eusales/WaterQuality/docs/hardware/pinout.md

| GPIO | Pino físico | Função | Barramento |
|---|---|---|---|
| GPIO 18 | 30 | SCK | SPI (TFT + SD) |
| GPIO 23 | 37 | MOSI | SPI (TFT + SD) |
| GPIO 19 | 31 | MISO | SPI (SD) |
| GPIO 5 | 29 | CS — TFT ST7789 | SPI |
| GPIO 15 | 23 | CS — SD Card | SPI |
| GPIO 2 | 24 | DC — TFT | SPI |
| GPIO 4 | 26 | RST — TFT | SPI |
| GPIO 21 | 33 | SDA — ADS1115 | I²C |
| GPIO 22 | 36 | SCL — ADS1115 | I²C |
| GPIO 13 | 15 | DATA — DS18B20 | 1-Wire |
| GPIO 32 | 7 | Botão Navegar | Digital |
| GPIO 33 | 8 | Botão Confirmar | Digital |
| GPIO 25 | 9 | Botão Voltar | Digital |
