eusales/WaterQuality/docs/hardware/pinout_WaterQuality.xlsx

Sheet: Pinout Geral
Pinout — Monitor Portátil de Qualidade da Água
ESP32 DevKit V3 (WROOM-32) | Instrumentação Industrial II — UFMT
GPIO | Barramento | Função | Sinal / Pino do periférico | Observação
GPIO 18 | SPI (compartilhado) | SCK | TFT SCL + SD SCK | Barramento único, CS dedicado por dispositivo
GPIO 23 | SPI (compartilhado) | MOSI | TFT SDA + SD MOSI | Barramento único
GPIO 19 | SPI (compartilhado) | MISO | SD MISO (TFT não usa)
GPIO 5 | SPI — TFT ST7789 | CS | Chip Select TFT
GPIO 17 | SPI — TFT ST7789 | DC | Data/Command TFT | Movido do GPIO 2 (conflito com LED onboard)
GPIO 4 | SPI — TFT ST7789 | RST | Reset TFT
GPIO 15 | SPI — SD Card | CS | Chip Select SD | Não usar pull-down externo — atrasa boot
GPIO 21 | I²C (via TXS0108E) | SDA | TXS0108E A2 → B2 → ADS1115 SDA | 3,3V no lado ESP32, 5V no lado ADS1115
GPIO 22 | I²C (via TXS0108E) | SCL | TXS0108E A1 → B1 → ADS1115 SCL | 3,3V no lado ESP32, 5V no lado ADS1115
GPIO 32 | Digital (INPUT_PULLUP) | Botão Navegar | GPIO → GND | Debounce 20 ms por software
GPIO 33 | Digital (INPUT_PULLUP) | Botão Confirmar | GPIO → GND | Debounce 20 ms por software
GPIO 25 | Digital (INPUT_PULLUP) | Botão Voltar | GPIO → GND | Debounce 20 ms por software

Sheet: ADS1115 — Canais
Mapa de Canais — ADS1115
Endereço I²C: 0x48 (ADDR → GND) | VDD = 5V | Ganho: GAIN_ONE (±4.096V)
Canal | Sensor | Faixa esperada | Observação
AIN0 | Turbidez — TS-300B | Conforme curva empírica (regressão 2º grau) | Alimentado em 5V, saída direta ao ADS1115
AIN1 | TDS — Gravity Analog TDS | 0 – 2,3 V | Compensação de temperatura via DS18B20
AIN2 | pH — PH4502C | ~1,0 – 4,0 V | Calibração de 3 pontos (pH 4, 7, 10)
AIN3 | 1-Wire | DATA | DS18B20 | Pull-up 4,7kΩ obrigatório para 3,3V

Sheet: TXS0108E
Conexões — TXS0108E (Level Shifter Digital)
Uso exclusivo no barramento I²C digital — NUNCA na cadeia analógica
Pino TXS0108E | Conectado a | Observação
VCCA | 3,3V (ESP32) | Lado A — domínio 3,3V
VCCB | 5V (Vin ESP32) | Lado B — domínio 5V
GND | GND comum
OE | 3,3V (VCCA) | Habilita o conversor permanentemente
A1 | GPIO 22 (SCL ESP32) | I²C SCL 3,3V → ESP32
B1 | SCL ADS1115 | I²C SCL 5V → ADS1115
A2 | GPIO 21 (SDA ESP32) | I²C SDA 3,3V → ESP32
B2 | SDA ADS1115 | I²C SDA 5V → ADS1115

Sheet: GPIOs — Regras
Regras de GPIO — ESP32 DevKit V3
GPIO(s) | Status | Motivo / Observação
GPIO 6 – 11 | PROIBIDO | Conectados à flash interna — travam o boot do ESP32
GPIO 34 – 39 | PROIBIDO | Somente entrada (input only), sem pull-up interno
GPIO 0 | PROIBIDO | Botão de boot — usar altera o modo de flash
GPIO 1 / 3 | PROIBIDO | TX0 / RX0 — usados pelo Serial/USB
GPIO 2 | EM USO ANTERIOR (realocado) | Tinha conflito com LED onboard — DC do TFT foi movido para GPIO 17
GPIO 12 | LIVRE | Disponível para expansão
GPIO 14 | LIVRE | Disponível para expansão
GPIO 16 | LIVRE | Disponível para expansão
GPIO 27 | LIVRE | Disponível para expansão
