eusales/WaterQuality/docs/README.md

# Documentação do WaterQuality

Comece pelo [README principal](../README.md) para conhecer o projeto, preparar o ambiente e consultar as pendências do MVP.

| Área | Documento |
| --- | --- |
| Firmware | [Arquitetura e responsabilidades dos módulos](firmware/arquitetura_firmware.md) |
| Firmware | [Equações e procedimentos de calibração](firmware/calibracao_firmware.md) |
| Hardware | [Pinout](hardware/pinout.md) |
| Hardware | [Planilha de ligações](hardware/pinout_WaterQuality.xlsx) |
| Interface | [Especificação da IHM](ihm/ihm_monitor_agua.md) |
| Interface | [Roteiro de teste da IHM](ihm/teste_ihm.md) |
| Relatórios | [Testes dos sensores](reports/relatorio_testes_sensores.docx) |

Os documentos técnicos foram preservados como referências de projeto. Eles podem descrever funcionalidades pretendidas; confira o estado atual no README principal e no [firmware](../monitor_agua/).

Os diagramas e modelos físicos estão em [hardware](../hardware/README.md), e os sketches de teste estão em [examples](../examples/README.md).
