eusales/WaterQuality/hardware/3d/tampa_cabeçot_.stl

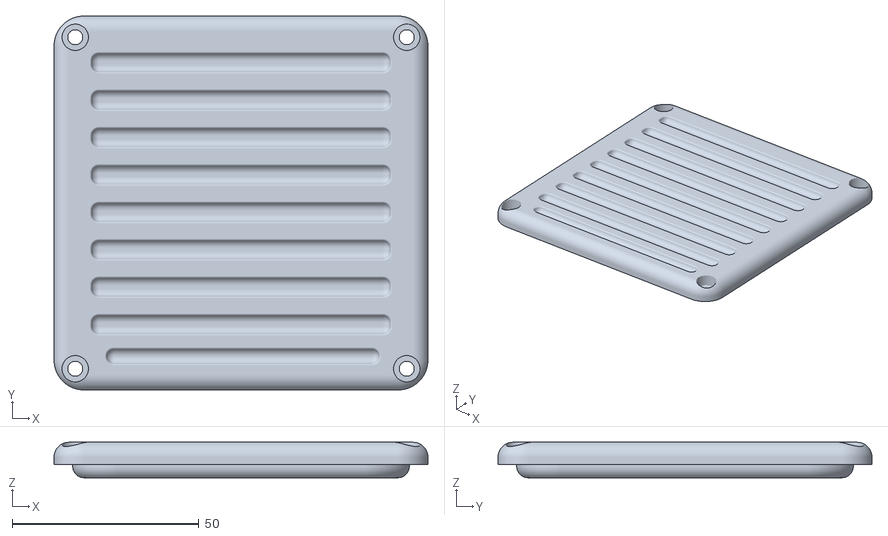
[picture p2: CAD file, 2026-07-13]
hardware/3d/tampa_cabeçot_.stl
100.0 x 100.0 x 9.50
