eusales/WaterQuality/hardware/3d/tampa_tela_mk1 v1.stl

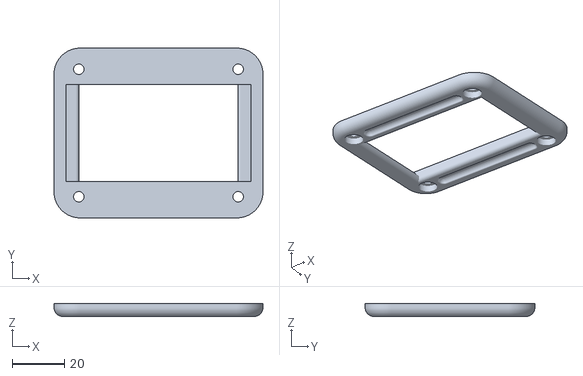
[picture p3: CAD file, 2026-07-13]
hardware/3d/tampa_tela_mk1 v1.stl
80.0 x 65.0 x 5.00
