eusales/WaterQuality/hardware/3d/sensor_corpo_covd19_.stl

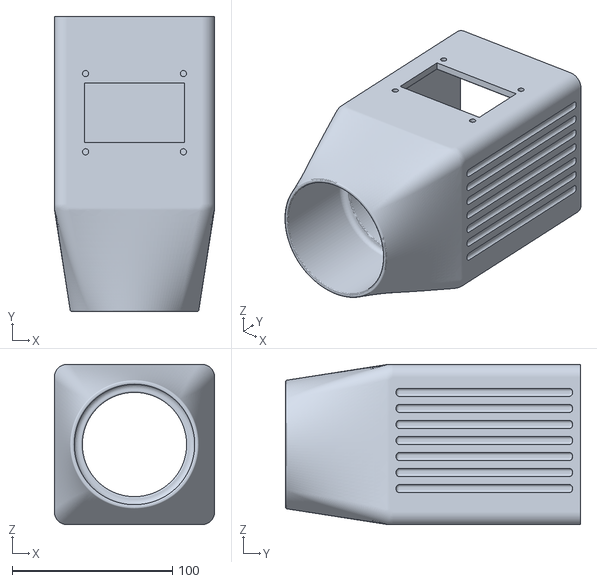
[picture p4: CAD file, 2026-07-13]
hardware/3d/sensor_corpo_covd19_.stl
100.0 x 184.0 x 100.0
