eusales/WaterQuality/hardware/3d/flange_istrument_sensor.stl

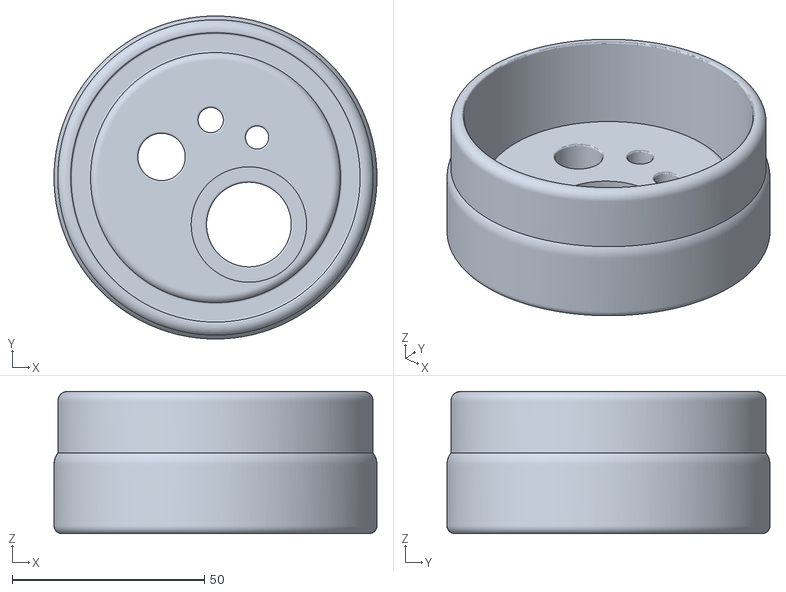
[picture p5: CAD file, 2026-07-13]
hardware/3d/flange_istrument_sensor.stl
84.0 x 84.0 x 37.0
