eusales/WaterQuality/docs/reports/relatorio_testes_sensores.docx

UNIVERSIDADE FEDERAL DE MATO GROSSO

Engenharia de Controle e Automação — Instrumentação Industrial II

Relatório de Testes de Sensores

Monitor Portátil de Qualidade da Água

Turbidez (TS-300B) | TDS (Gravity Analog) | pH (PH4502C)

Matheus Sales

matheus.sales@sou.ufmt.br

Cuiabá — MT, 2025

# 1. Introdução

Este documento registra os testes individuais e integrados dos sensores analógicos do monitor portátil de qualidade da água desenvolvido para a disciplina de Instrumentação Industrial II. O objetivo é validar o funcionamento e a leitura de cada sensor antes da integração completa do firmware.

Os testes seguem a seguinte sequência:

1. Sensor de turbidez (TS-300B) — individual
2. Sensor de TDS (Gravity Analog TDS) — individual
3. Sensor de pH (PH4502C) — individual
4. Teste integrado dos três sensores simultaneamente

# 2. Arquitetura de Aquisição de Dados

Todos os sensores deste relatório possuem saída analógica de tensão. O fluxo de dados adotado é:

Sensor (analógico) → ADS1115 (5 V) → TXS0108E → ESP32 (3,3 V)

Justificativa de cada estágio:

- Sensores alimentados em 5 V — saídas analógicas podem superar 3,3 V
- ADS1115 alimentado em 5 V — aceita entradas analógicas de até ~5,5 V sem dano, resolve a incompatibilidade de tensão no domínio analógico com resolução de 16 bits
- Comunicação ADS1115 → ESP32 via I²C — sinal digital em nível 5 V
- TXS0108E (bidirecional, digital) — converte I²C de 5 V (lado B) para 3,3 V (lado A), protegendo o ESP32

⚠ O TXS0108E opera APENAS no barramento I²C digital. Nunca inserir o TXS0108E na cadeia analógica — distorceria o sinal.

# 3. Hardware e Pinagem Geral

## 3.1 ADS1115 — Conexões fixas (todos os testes)

O ADS1115 permanece conectado da mesma forma em todos os testes. Apenas o canal AINx utilizado muda conforme o sensor.

Pino ADS1115 | Conectado a | Observação
VDD | 5 V (Vin ESP32) | Alimentação 5 V — habilita entrada analógica até ~5,5 V
GND | GND comum | GND único entre ESP32, ADS e sensores
SCL | TXS0108E — Lado B (B1) | I²C clock — 5 V
SDA | TXS0108E — Lado B (B2) | I²C dados — 5 V
ADDR | GND | Endereço I²C = 0x48
ALRT | Não conectar | —

## 3.2 TXS0108E — Conexões fixas (todos os testes)

Pino TXS0108E | Conectado a | Observação
VCCA | 3,3 V (ESP32) | Lado A — domínio 3,3 V
VCCB | 5 V (Vin ESP32) | Lado B — domínio 5 V
GND | GND comum
OE | 3,3 V (VCCA) | Habilita o conversor permanentemente
A1 | GPIO 22 — SCL ESP32 | I²C SCL 3,3 V → ESP32
B1 | SCL ADS1115 | I²C SCL 5 V → ADS1115
A2 | GPIO 21 — SDA ESP32 | I²C SDA 3,3 V → ESP32
B2 | SDA ADS1115 | I²C SDA 5 V → ADS1115

## 3.3 DS18B20 — Conexões fixas (todos os testes)

O DS18B20 é utilizado em todos os testes pois fornece compensação de temperatura para o cálculo do TDS e registro de temperatura ambiente da amostra.

Pino DS18B20 | Conectado a | Observação
VDD | 3,3 V
GND | GND comum
DATA | GPIO 13 (ESP32) | 1-Wire — pull-up 4,7 kΩ para 3,3 V obrigatório

⚠ Sem o resistor pull-up de 4,7 kΩ entre DATA e 3,3 V, o DS18B20 retorna 85°C fixo (valor de erro padrão Maxim).

# 4. Teste 1 — Sensor de Turbidez TS-300B

## 4.1 Objetivo

Validar a leitura analógica do sensor de turbidez TS-300B pelo ADS1115 e estabelecer a curva empírica de calibração tensão × NTU, necessária para conversão dos valores no firmware.

## 4.2 Especificações do sensor

Parâmetro | Valor
Alimentação | 5 V DC
Saída analógica | Tensão variável (verificar nível máximo com multímetro)
Saída digital | Nível lógico — limiar ajustável por potenciômetro (não utilizada neste teste)
Princípio | Dispersão de luz infravermelha por partículas em suspensão

## 4.3 Pinagem — TS-300B

Pino TS-300B | Conectado a | Observação
VCC | 5 V (Vin ESP32) | Alimentação 5 V
GND | GND comum
A (saída analógica) | ADS1115 — AIN0 | Sinal analógico direto — sem divisor resistivo
D (saída digital) | Não conectar | Não utilizada neste teste

✔ A saída analógica vai direto ao ADS1115 (alimentado em 5 V), que suporta entradas até ~5,5 V. Sem necessidade de divisor resistivo.

## 4.4 Procedimento de calibração empírica

Por não possuir curva de calibração oficial publicada pelo fabricante, o TS-300B requer caracterização empírica com amostras de referência.

5. Preparar 3 amostras de referência em recipientes idênticos:
- Amostra A: água destilada — referência ~0 NTU
- Amostra B: água com argila diluída (1 g/L) — ~50 NTU
- Amostra C: água com argila concentrada (5 g/L) — ~300–500 NTU
6. Para cada amostra, mergulhar o sensor, aguardar 5 segundos para estabilização e registrar a tensão média de 20 leituras do ADS1115 no AIN0.
7. Plotar a curva Tensão (V) × NTU e ajustar regressão polinomial de 2° grau: NTU = a·V² + b·V + c
8. Registrar os coeficientes a, b e c na tabela de resultados.

⚠ Medir com multímetro a tensão de saída do TS-300B com o sensor no ar (sem água) e com água destilada antes de conectar ao ADS1115, para confirmar que não ultrapassa 5 V.

## 4.5 Código de teste — Turbidez individual

Copiar para o Arduino IDE. Abre o Serial Monitor a 115200 baud.

// ============================================================

// TESTE 1 — Sensor de Turbidez TS-300B

// ADS1115 (5V) → TXS0108E → ESP32 | Leitura no AIN0

// DS18B20 no GPIO 13 (pull-up 4k7 para 3.3V)

// ============================================================

#include <Wire.h>

#include <Adafruit_ADS1X15.h>

#include <OneWire.h>

#include <DallasTemperature.h>

#define ONE_WIRE_BUS 13

Adafruit_ADS1115 ads;

OneWire oneWire(ONE_WIRE_BUS);

DallasTemperature sensors(&oneWire);

// Canais do ADS1115

#define CH_TURBIDEZ 0

// Ganho: GAIN_ONE = ±4.096V (resolução 0.125 mV/bit)

// Com ADS alimentado em 5V, entradas até ~5.5V são seguras

// mas o PGA limita a conversão a ±4.096V — adequado para TS-300B

void setup() {

Serial.begin(115200);

Wire.begin(21, 22); // SDA=21, SCL=22

if (!ads.begin(0x48)) {

Serial.println("ERRO: ADS1115 nao encontrado. Verifique conexoes I2C.");

while (1);

}

ads.setGain(GAIN_ONE); // ±4.096V

sensors.begin();

Serial.println("DS18B20 iniciado.");

Serial.println("============================================");

Serial.println("TESTE 1 — Turbidez TS-300B");

Serial.println("Formato: Amostra | Tensao(V) | Temp(C)");

Serial.println("============================================");

delay(1000);

}

void loop() {

// Leitura do ADS1115 — AIN0 (turbidez)

int16_t raw = ads.readADC_SingleEnded(CH_TURBIDEZ);

float voltage = ads.computeVolts(raw);

// Leitura de temperatura

sensors.requestTemperatures();

float temp = sensors.getTempCByIndex(0);

// Exibição no Serial Monitor

Serial.print("Turbidez | Tensao: ");

Serial.print(voltage, 4);

Serial.print(" V | Temp: ");

Serial.print(temp, 2);

Serial.println(" C");

// Para calibração: registre manualmente o NTU de cada amostra

// e anote a tensão correspondente para montar a curva

delay(500);

}

## 4.6 Tabela de resultados — Turbidez

Preencher durante o teste:

Amostra | NTU estimado | Tensão média (V) | Temperatura (°C) | Observações
Água destilada | ~0 | 3,3416 | 21,75
Argila diluída (1 g/L) | ~50 | 1,8793 | 22,12
Argila concentrada (5 g/L) | ~300–500 | 0,3305 | 21,62
Amostra real (torneira) | —

# 5. Teste 2 — Sensor de TDS (Gravity Analog TDS)

## 5.1 Objetivo

Validar a leitura do sensor de sólidos totais dissolvidos (TDS) e aplicar a calibração de 1 ponto com compensação de temperatura via DS18B20.

## 5.2 Especificações do sensor

Parâmetro | Valor
Alimentação | 3,3–5,5 V DC
Saída analógica máxima | 2,3 V (segura para ADS1115 em qualquer configuração)
Faixa de medição | 0–1000 ppm
Resolução | 0,0023 V/ppm (1 ppm por LSB no conversor)
Consumo | 3–6 mA

## 5.3 Pinagem — TDS Gravity

Pino TDS Gravity | Conectado a | Observação
VCC | 5 V (Vin ESP32) | Alimentado em 5 V para consistência
GND | GND comum
A (saída analógica) | ADS1115 — AIN1 | Saída máx. 2,3 V — segura

## 5.4 Procedimento de calibração — 1 ponto + compensação

9. Preparar solução padrão de condutividade de 1413 µS/cm a 25°C (solução de calibração comercial).
10. Mergulhar a sonda TDS e o DS18B20 na solução. Aguardar 30 segundos.
11. Registrar temperatura T e tensão V_raw do ADS1115 (AIN1).
12. O firmware calcula automaticamente EC25 e o fator k. Anotar k na tabela de resultados.
13. Verificar leitura em amostras de concentração conhecida (água destilada = 0 ppm, água de torneira típica = 100–300 ppm).

Equações aplicadas no firmware:

// Compensação de temperatura (normaliza para 25°C)

EC25 = EC_bruto / (1.0 + 0.02 * (temperatura - 25.0));

// Fator de ganho k (calculado na calibração, salvo em NVS)

k = 1413.0 / EC25;

// Leitura corrigida em toda medição futura

EC_corr = EC_bruto * k / (1.0 + 0.02 * (temperatura - 25.0));

TDS_ppm = EC_corr / 2.0;

## 5.5 Código de teste — TDS individual

// ============================================================

// TESTE 2 — Sensor TDS Gravity Analog

// ADS1115 (5V) → TXS0108E → ESP32 | Leitura no AIN1

// DS18B20 no GPIO 13 — compensacao de temperatura

// ============================================================

#include <Wire.h>

#include <Adafruit_ADS1X15.h>

#include <OneWire.h>

#include <DallasTemperature.h>

#define ONE_WIRE_BUS 13

Adafruit_ADS1115 ads;

OneWire oneWire(ONE_WIRE_BUS);

DallasTemperature sensors(&oneWire);

#define CH_TDS 1

// Fator k obtido na calibracao (ajustar apos o teste)

float k_tds = 1.0;

float calcTDS(float voltage, float temp) {

// Converte tensao para condutividade bruta (aproximacao linear)

float ec_bruto = voltage * 1000.0 / 2.3; // escala 0-2.3V → 0-1000 uS/cm

float ec25 = ec_bruto / (1.0 + 0.02 * (temp - 25.0));

float ec_corr = ec25 * k_tds;

return ec_corr / 2.0; // TDS em ppm

}

void setup() {

Serial.begin(115200);

Wire.begin(21, 22);

if (!ads.begin(0x48)) {

Serial.println("ERRO: ADS1115 nao encontrado.");

while (1);

}

ads.setGain(GAIN_ONE);

sensors.begin();

Serial.println("============================================");

Serial.println("TESTE 2 — TDS Gravity Analog");

Serial.println("Formato: Tensao(V) | Temp(C) | TDS(ppm)");

Serial.println("============================================");

delay(1000);

}

void loop() {

int16_t raw = ads.readADC_SingleEnded(CH_TDS);

float voltage = ads.computeVolts(raw);

sensors.requestTemperatures();

float temp = sensors.getTempCByIndex(0);

float tds = calcTDS(voltage, temp);

Serial.print("TDS | Tensao: ");

Serial.print(voltage, 4);

Serial.print(" V | Temp: ");

Serial.print(temp, 2);

Serial.print(" C | TDS: ");

Serial.print(tds, 1);

Serial.println(" ppm");

delay(500);

}

## 5.6 Tabela de resultados — TDS

Amostra | TDS referência (ppm) | Tensão (V) | Temperatura (°C) | TDS calculado (ppm) | Desvio (%)
Água destilada | ~0
Sol. padrão 1413 µS/cm | ~707
Água torneira | —
Água com sal (1 g/L) | —

# 6. Teste 3 — Sensor de pH (PH4502C)

## 6.1 Objetivo

Validar a leitura de pH e executar a calibração de 3 pontos (pH 4, 7 e 10), registrando os coeficientes de inclinação ácida e básica que serão utilizados pelo firmware.

## 6.2 Especificações do sensor

Parâmetro | Valor
Alimentação | 5 V DC — OBRIGATÓRIO (não funciona corretamente em 3,3 V)
Saída analógica | Variável conforme pH — pode superar 3,3 V
Faixa de pH | 0–14
Vida útil do eletrodo | ~1 ano (eletrodo de vidro)

## 6.3 Pinagem — PH4502C

Pino PH4502C | Conectado a | Observação
VCC | 5 V (Vin ESP32) | 5 V EXATOS — tensão crítica para precisão
GND | GND comum | GND único — ruído de terra afeta diretamente a leitura de pH
Po (saída analógica) | ADS1115 — AIN2 | Sinal analógico direto — ADS em 5 V suporta a tensão
Do (saída digital) | Não conectar | Não utilizada
To (temperatura) | Não conectar | Não utilizada — DS18B20 usado no lugar

⚠ O aterramento do PH4502C deve ser o mesmo GND do ADS1115 e do ESP32. GND separado ou com diferença de potencial distorce a leitura analógica.

## 6.4 Procedimento de calibração — 3 pontos

14. Com o módulo alimentado em 5 V, aplicar curto-circuito no conector BNC e ajustar o potenciômetro de offset até a saída marcar 2,5 V no multímetro.
15. Mergulhar o eletrodo na solução tampão pH 7,00. Aguardar estabilização (30–60 s). Registrar V7 = valor do offset.
16. Mergulhar na solução tampão pH 4,00. Aguardar estabilização. Registrar V4.
17. Mergulhar na solução tampão pH 10,01. Aguardar estabilização. Registrar V10.
18. Calcular as inclinações conforme abaixo e registrar na tabela.

// Inclinacao acida (pH 4 a pH 7)

slope_acid = (7.0 - 4.0) / (V7 - V4);

// Inclinacao basica (pH 7 a pH 10)

slope_basic = (7.0 - 10.0) / (V7 - V10);

// Conversao tensao → pH

if (voltage < V7)

pH = slope_acid * (voltage - offset) + 7.0;

else

pH = slope_basic * (voltage - offset) + 7.0;

## 6.5 Código de teste — pH individual

// ============================================================

// TESTE 3 — Sensor de pH PH4502C

// ADS1115 (5V) → TXS0108E → ESP32 | Leitura no AIN2

// Calibracao de 3 pontos — ajustar constantes abaixo

// ============================================================

#include <Wire.h>

#include <Adafruit_ADS1X15.h>

#include <OneWire.h>

#include <DallasTemperature.h>

#define ONE_WIRE_BUS 13

Adafruit_ADS1115 ads;

OneWire oneWire(ONE_WIRE_BUS);

DallasTemperature sensors(&oneWire);

#define CH_PH 2

// Preencher com valores medidos na calibracao

float ph_offset = 2.5; // V7 — tensao no pH 7

float ph_slope_acid = -5.0; // ajustar com medicao real

float ph_slope_bas = 5.0; // ajustar com medicao real

float calcPH(float voltage) {

if (voltage < ph_offset)

return ph_slope_acid * (voltage - ph_offset) + 7.0;

else

return ph_slope_bas * (voltage - ph_offset) + 7.0;

}

void setup() {

Serial.begin(115200);

Wire.begin(21, 22);

if (!ads.begin(0x48)) {

Serial.println("ERRO: ADS1115 nao encontrado.");

while (1);

}

ads.setGain(GAIN_ONE);

sensors.begin();

Serial.println("============================================");

Serial.println("TESTE 3 — pH PH4502C");

Serial.println("Formato: Tensao(V) | Temp(C) | pH");

Serial.println("============================================");

delay(1000);

}

void loop() {

int16_t raw = ads.readADC_SingleEnded(CH_PH);

float voltage = ads.computeVolts(raw);

sensors.requestTemperatures();

float temp = sensors.getTempCByIndex(0);

float ph = calcPH(voltage);

Serial.print("pH | Tensao: ");

Serial.print(voltage, 4);

Serial.print(" V | Temp: ");

Serial.print(temp, 2);

Serial.print(" C | pH: ");

Serial.println(ph, 2);

delay(500);

}

## 6.6 Tabela de resultados — pH

Amostra | pH referência | Tensão (V) | Temperatura (°C) | pH calculado | Desvio
Tampão pH 4,00 | 4,00
Tampão pH 7,00 | 7,00
Tampão pH 10,01 | 10,01
Água torneira | ~7,0–8,0
Vinagre | ~2,5–3,0

# 7. Teste 4 — Integrado (Turbidez + TDS + pH simultâneos)

## 7.1 Objetivo

Validar o funcionamento simultâneo dos três sensores no mesmo barramento ADS1115, confirmar ausência de interferência entre canais e verificar estabilidade das leituras em condições reais.

## 7.2 Mapa de canais ADS1115 — Teste integrado

Canal ADS1115 | Sensor | Pino do sensor | Faixa esperada
AIN0 | Turbidez TS-300B | Saída analógica (A) | Conforme curva empírica
AIN1 | TDS Gravity | Saída analógica | 0–2,3 V
AIN2 | pH PH4502C | Po (saída analógica) | ~1,0–4,0 V
AIN3 | Reserva | — | Disponível para expansão

## 7.3 Código de teste — Integrado

Este código aplica as calibrações definidas nos testes individuais. Atualizar as constantes antes de executar.

// ============================================================

// TESTE 4 — Integrado: Turbidez + TDS + pH

// ADS1115 AIN0=Turbidez | AIN1=TDS | AIN2=pH

// DS18B20 GPIO 13 — temperatura e compensacao TDS

// ============================================================

#include <Wire.h>

#include <Adafruit_ADS1X15.h>

#include <OneWire.h>

#include <DallasTemperature.h>

#define ONE_WIRE_BUS 13

Adafruit_ADS1115 ads;

OneWire oneWire(ONE_WIRE_BUS);

DallasTemperature sensors(&oneWire);

#define CH_TURBIDEZ 0

#define CH_TDS 1

#define CH_PH 2

// ── Constantes de calibracao ─────────────────────────────

// Turbidez: coeficientes da regressao empirica NTU = a*V^2 + b*V + c

float turb_a = 0.0; // ajustar com resultado do Teste 1

float turb_b = 0.0;

float turb_c = 0.0;

// TDS: fator de ganho k (Teste 2)

float k_tds = 1.0;

// pH: offset e inclinacoes (Teste 3)

float ph_offset = 2.5;

float ph_slope_ac = -5.0;

float ph_slope_bas = 5.0;

// ── Funcoes de conversao ─────────────────────────────────

float calcNTU(float v) {

return turb_a * v * v + turb_b * v + turb_c;

}

float calcTDS(float v, float temp) {

float ec_bruto = v * 1000.0 / 2.3;

float ec25 = ec_bruto / (1.0 + 0.02 * (temp - 25.0));

return (ec25 * k_tds) / 2.0;

}

float calcPH(float v) {

if (v < ph_offset)

return ph_slope_ac * (v - ph_offset) + 7.0;

else

return ph_slope_bas * (v - ph_offset) + 7.0;

}

void setup() {

Serial.begin(115200);

Wire.begin(21, 22);

if (!ads.begin(0x48)) {

Serial.println("ERRO: ADS1115 nao encontrado.");

while (1);

}

ads.setGain(GAIN_ONE);

sensors.begin();

Serial.println("========================================================");

Serial.println("TESTE 4 — Integrado: Turbidez | TDS | pH");

Serial.println("Turbidez(NTU) | TDS(ppm) | pH | Temp(C)");

Serial.println("========================================================");

delay(1000);

}

void loop() {

// Leitura de temperatura (necessaria antes do TDS)

sensors.requestTemperatures();

float temp = sensors.getTempCByIndex(0);

// Leitura dos tres canais

float v_turb = ads.computeVolts(ads.readADC_SingleEnded(CH_TURBIDEZ));

float v_tds = ads.computeVolts(ads.readADC_SingleEnded(CH_TDS));

float v_ph = ads.computeVolts(ads.readADC_SingleEnded(CH_PH));

// Conversoes calibradas

float ntu = calcNTU(v_turb);

float tds = calcTDS(v_tds, temp);

float ph = calcPH(v_ph);

// Saida formatada

Serial.print("Turb: "); Serial.print(ntu, 1); Serial.print(" NTU | ");

Serial.print("TDS: "); Serial.print(tds, 1); Serial.print(" ppm | ");

Serial.print("pH: "); Serial.print(ph, 2); Serial.print(" | ");

Serial.print("Temp: "); Serial.print(temp, 2); Serial.println(" C");

delay(1000);

}

## 7.4 Tabela de resultados — Teste integrado

Amostra | Turbidez (NTU) | TDS (ppm) | pH | Temp (°C) | Observações
Água destilada
Água torneira
Amostra 1
Amostra 2

# 8. Bibliotecas Necessárias

Instalar via Arduino IDE → Gerenciador de Bibliotecas:

Biblioteca | Versão recomendada | Finalidade
Adafruit ADS1X15 | ≥ 2.5.0 | Leitura do ADS1115 via I²C
OneWire | ≥ 2.3.7 | Protocolo 1-Wire para DS18B20
DallasTemperature | ≥ 3.9.0 | Leitura de temperatura DS18B20
Wire (built-in) | — | I²C nativo ESP32

# 9. Checklist de Montagem

Verificar antes de energizar:

- ADS1115: VDD em 5 V, ADDR em GND (0x48), SDA/SCL via TXS0108E
- TXS0108E: VCCA = 3,3 V, VCCB = 5 V, OE = 3,3 V, A1/A2 no ESP32, B1/B2 no ADS1115
- DS18B20: resistor pull-up 4,7 kΩ entre DATA e 3,3 V
- PH4502C: VCC = 5 V exatos, GND comum com ADS1115
- TS-300B: VCC = 5 V, saída analógica em AIN0 do ADS1115
- TDS Gravity: VCC = 5 V, saída analógica em AIN1 do ADS1115
- GND único e comum entre ESP32, ADS1115, TXS0108E e todos os sensores
- Cartão SD formatado em FAT32 inserido antes de energizar (não usado nesta fase de testes)

Instrumentação Industrial II — UFMT Página

Relatório de Testes — Monitor de Qualidade da Água | ESP32 + ADS1115
