eusales/WaterQuality/(list of files, drawings)

Other design files:
hardware/fritzing/WaterQuality1.fzz
