eusales/WaterQuality/monitor_agua/src/buzzer.cpp

#include "buzzer.h"

void inicializarBuzzer() {
  pinMode(BUZZER, OUTPUT);
  digitalWrite(BUZZER, LOW);
}

void bipAlerta() {
  digitalWrite(BUZZER, HIGH);
  delay(100);
  digitalWrite(BUZZER, LOW);
}

void bipConfirmacao() {
  digitalWrite(BUZZER, HIGH);
  delay(80);
  digitalWrite(BUZZER, LOW);
  delay(80);
  digitalWrite(BUZZER, HIGH);
  delay(80);
  digitalWrite(BUZZER, LOW);
}

void bipErro() {
  for (int i = 0; i < 3; i++) {
    digitalWrite(BUZZER, HIGH);
    delay(200);
    digitalWrite(BUZZER, LOW);
    delay(200);
  }
}
