eusales/WaterQuality/monitor_agua/src/display.h

#ifndef DISPLAY_H
#define DISPLAY_H

#include "config.h"

void inicializarDisplay();
void desenharSplash();
void desenharTela(Estado e);

void desenharTela1_Monitoramento();
void desenharTela2_Menu();
void desenharTela3_Calibracao();
void desenharTela4_Registro();
void desenharTela5_Historico();
void desenharTela6_Configuracoes();

#endif
