eusales/WaterQuality/(commit log)

2026-07-13 feat: MVP completo - monitor de qualidade da agua ESP32
    - Firmware modular: 10 modulos (config, sensores, display, maquina, botoes, buzzer, sd_log, nvs_cal, web, main)
    - IHM: 6 telas com splash screen, menu, calibracao, medicao, config, historico
    - Sensores: pH (ADS1115 + BNC), TDS (ADC), Turbidez (ADC), Temperatura (DS18B20)
    - Calibracao 3 pontos pH, calibracao TDS, turbidez polinomial
    - NVS + backup JSON no SD
    - CSV logging automatico
    - Documentacao: manual LaTeX, calibracao com equacoes, relatorio tecnico
    - Build limpo: 0 erros, 0 warnings, RAM 7.0%, Flash 30.0%
    [WaterQuality.fzz, WaterQuality1.fzz, flange_istrument_sensor.stl, pinout_WaterQuality.xlsx, sensor_corpo_covd19_.stl, tampa_cabeçot_.stl, tampa_tela_mk1 v1.stl]
2026-07-13 chore: remove arquivos nao essenciais do repositorio
    Removidos: screenshots, Fritzing principal, handoff_prompt, prompt_codificacao,
    relatorio_firmware, manual_usuario.tex. README atualizado sem referencias removidas.
    [WaterQuality.fzz, WaterQuality1.fzz]
2026-10-26 chore: organiza documentação, hardware e exemplos do WaterQuality
    [WaterQuality1.fzz, flange_istrument_sensor.stl, pinout_WaterQuality.xlsx, sensor_corpo_covd19_.stl, tampa_cabeçot_.stl, tampa_tela_mk1 v1.stl]
